xinchen13/tinyriscv-modified/(commit log)

2024-05-15 update pwm
2024-05-15 before i2c
2024-05-15 add i2c fig
2024-05-16 update i2c doc
2024-05-18 modified i2c address
2024-05-19 update i2c
2024-05-22 modified i2c
2024-05-22 modified uart & sID
2024-05-23 update uart_debug
2024-05-23 update uart
2024-05-23 udapte i2c xdc
2024-05-24 update i2c test
2024-05-24 update led test
2024-05-24 update pwm test
2024-05-24 update pwm_test test
2024-05-25 udpate i2c div
2024-05-27 update uart freq capture
2024-05-27 update uart frep capture
2024-05-27 del useless
    [tinyriscv.cfg]
